breckenedge/parametric-brick-boxes/README.md

# Parametric brick boxes

Printable, parametric storage boxes, LEGO-compatible and written in OpenSCAD:
studded edge to edge on every side and on the lid (each face can be studs, sockets
or flat), with storage inside.

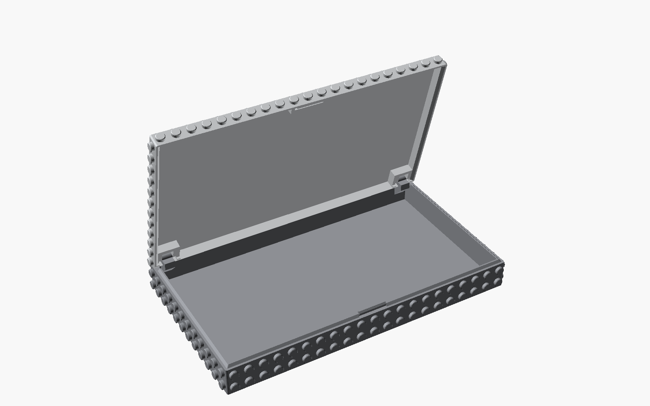
[picture p1: images/open.png]
A 21 x 12 stud box with its hinged lid open


| Closed | Studs only front and back |
|---|---|
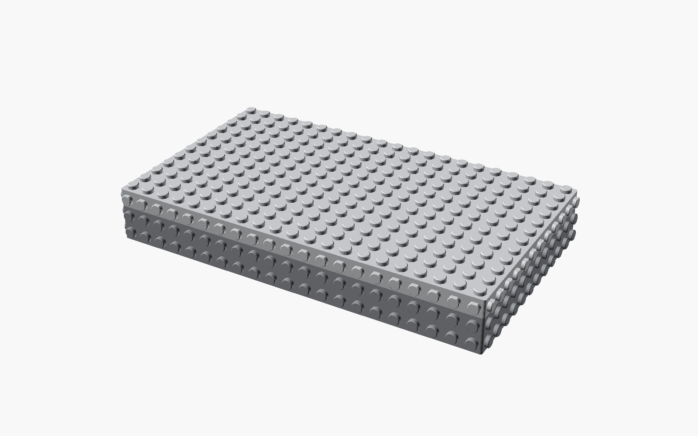
[picture p2: images/closed.png]
Closed box, studded on every face
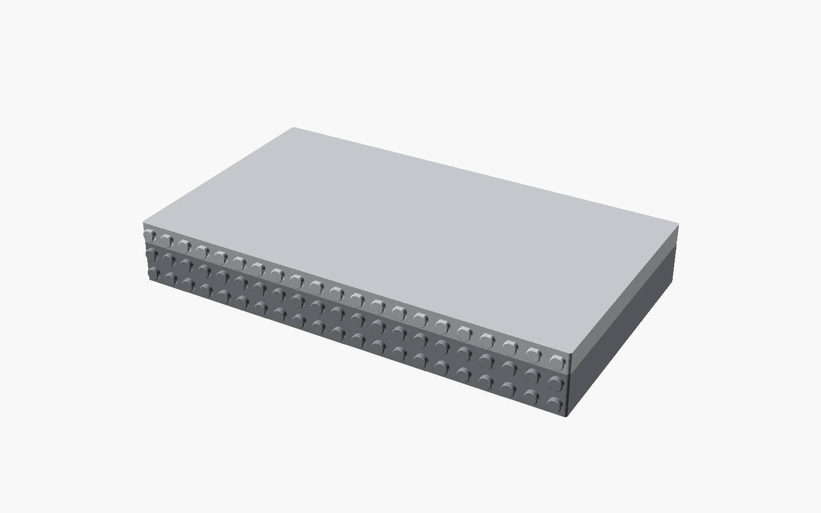
[picture p3: images/faces.png]
Box with a plain lid top and plain ends, studs only on the front and back
|  |  |
| **Print layout** | **Rows 0, 1 and 2** |
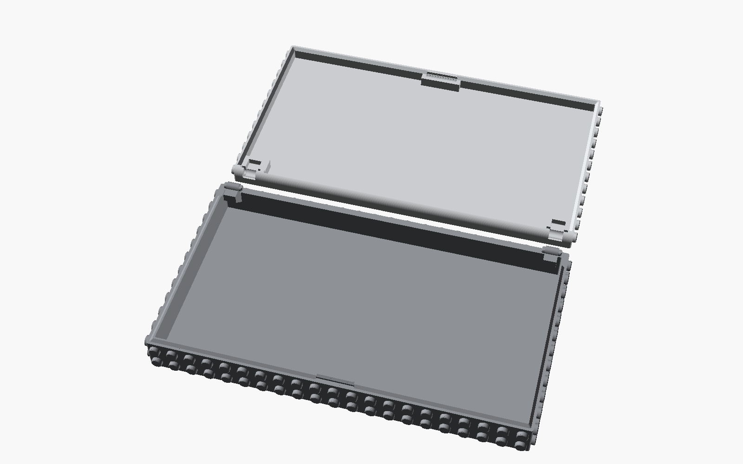
[picture p4: images/print.png]
Body upright, lid beside it
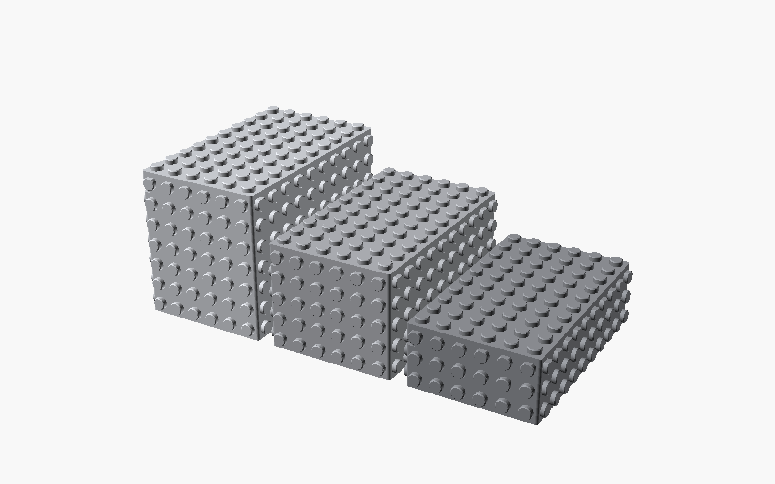
[picture p5: images/lineup.png]
Three boxes stepping up from front to back
|  |  |

- Everything is in LEGO units: footprints in studs (8 mm), heights in stud rows (8 mm).
- Box size is set directly in studs (`studs_l` x `studs_w`).
- Every box is whole stud rows tall, with studs round the lid band too, so the side
  studs of neighbouring boxes line up. `side_rows` sets the height and `lid_rows` how
  many of those rows are lid. A lid taller than one row swings out behind the box by
  8 mm per extra row when it's open.
- Every face (`top`, `bottom`, `front`, `back`, `left`, `right`) is set to `studs`,
  `sockets` or `flat` in the Customizer's **Studs** group. Sockets are built like a
  LEGO brick's underside: a shallow recess with hollow tubes between each group of four
  studs (small pins along a face only one stud wide), so a box presses onto a baseplate
  or onto another box's studs without a thick solid plate under it. Flat faces take
  a label, or stand flush against a wall or another box.
- Optional text label on the lid top (**Lid label** group): set `label`, and it's
  centred on the lid with the top studs or sockets round it left out. The text is
  engraved into the top skin (prints without supports) or raised off it (`label_style`),
  in any installed font (`label_font`), can lean into italics (`label_slant`) and can be
  turned to any angle (`label_rotate`).
- Set `row` for where the box will stand (0 = front): each row back is taller, so
  whatever stands on the boxes in back sits higher.
- Hinged lid on two pinned tabs at the back. On a two-piece box, friction holds it at any angle up to 90°,
  and it lifts off at 90°.
- Hollow lid: a thin top skin (`lid_top`, thickened automatically under top sockets) over
  an open underside, inside the outer lip, with solid blocks only round the hinge slots
  and the detent.
- Snaps shut on a detent: a bead on the front wall top clicks into the lid; squeeze the
  middle of the box front to release it (`detent_count`, `detent_len`; `detent_bump` sets
  how firm the snap is).
- By default (`part = print_in_place`) it prints as one piece, the body upright with the
  lid standing open on it: no assembly, and the hinge can't come apart (`pip_gap` sets
  the clearance between the parts). This only suits small lids: the open lid stands
  as tall as the box is wide (`studs_w`), and a tall one gets knocked over or takes
  the box with it. On the author's A1, a 6 x 5 box comes out well. An 8-stud-wide box
  failed at about the lid's third row of studs: the whole box came loose, even on the
  textured PEI plate. With the lid turned parallel to the Y axis (on a bed slinger the
  standing lid should be perpendicular to it), the lid wobbled badly at about 6 studs.
  OpenSCAD warns in the console when an open lid would stand over 5 studs tall.
  For a bigger box, pick `part = print` for two pieces, the body
  and the lid both upright, on a snug friction hinge you assemble: hold the lid straight
  up (open 90°) and press it onto the tabs. They only go in at that angle, and it lifts
  off the same way. The lid prints top up,
  its flat bottom edge on the bed, bridging over its hollow underside: on the author's A1,
  a 4 x 4 lid printed fine without supports. Or set `lid_inverted` to print it top down,
  with no bridge over the hollow (top studs then stand on the bed). The body needs supports only on bottom studs; with bottom
  `sockets` or `flat` it prints flat without supports. Print
  `stud_fit_test.scad` first to find your stud and socket sizes, then a small 6 x 5 box
  to check the whole fit.
  For reference, on the author's Bambu Lab A1 printing
  [SUNLU PLA 2.0+](https://www.breckenridge.dev/amazon.html?asin=B0FG7VTXTY) (affiliate link), these clutch
  well: `stud_d` (top studs) 5.05, `side_stud_d` (side studs) 4.95–5.00,
  `socket_d` (top and bottom sockets) 4.95 and `side_socket_d` (side sockets)
  4.85–4.95.

## Use

Open `parametric_brick_boxes.scad` in OpenSCAD (a recent nightly with the
Manifold backend renders much faster) and use the Customizer. Set the size and `row`,
pick `part = print_in_place / print / body / lid`, then render and export.

`tools/build_3mf.sh` builds ready-to-print Bambu Studio projects for the A1 (Windows, Git
Bash; it runs OpenSCAD and Bambu Studio), e.g. `tools/build_3mf.sh 3mf 6x5 16x8`. Boxes
up to 5 studs wide come out printed in place, wider ones in two pieces. Only the lid of a
two-piece box gets supports, tree supports from the bed under its long bridged top
(`LID_SUPPORTS=0` turns them off; `SUPPORTS=1` puts them everywhere, for bottom studs;
`LID_INVERTED=1` prints the lids top down instead, without them).
Every box gets a 5 mm outer brim, since
a body with bottom sockets only meets the bed with a thin rim (`BRIM=0` turns it off).
The printer, filament, process and stud sizes are variables at the top of the script.

`archive/` holds an earlier, decorative pillar version.

## License

© 2026 Aaron Breckenridge. Licensed under
[Creative Commons Attribution-ShareAlike 4.0 International](https://creativecommons.org/licenses/by-sa/4.0/)
(CC BY-SA 4.0); see [LICENSE](LICENSE).

The label's default font, [Fredoka](https://fonts.google.com/specimen/Fredoka)
(`fonts/Fredoka.ttf`), is © The Fredoka Project Authors, under the
[SIL Open Font License 1.1](fonts/OFL.txt).

LEGO® is a trademark of the LEGO Group, which does not sponsor, authorize or endorse
this project.

As an Amazon Associate I earn from qualifying purchases made through the product links
above.
