breckenedge/parametric-brick-boxes/(list of files, cad)

Other CAD files:
speed_champions_brick_boxes.scad
archive/speed_champions_pillars.scad
