breckenedge/parametric-brick-boxes/(commit log)

2026-10-12 Parametric brick display boxes for Speed Champions cars
    OpenSCAD boxes in LEGO units with studded lid and side panels, sized
    per car class and packed onto the shelf with back rows higher.
    [speed_champions_brick_boxes.scad, speed_champions_pillars.scad]
2026-10-13 Hinged lid, stud fit test, plinth bands, Customizer cleanup
    - Hinged lid (default): friction-fit pins on two buttressed tabs at the
    back, flatted so the lid only slides on or off at 90 degrees.
    lid_style = "seat" keeps the plain lift-off lid.
    - Customizer: descriptions moved above parameters so dropdowns and
    sliders work; fig_side / fig_align are now dropdowns; car_h removed;
    car_l minimum is 6.
    - Studs: chamfered 1.8 mm profile; new stud_fit_test.scad prints a
    strip of upright and sideways studs at six diameters.
    - Recessed plinth band at the bottom of the body, mirrored at the top
    of the lid, to hide the first-layer / cooling line.
    - Gray preview colours.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
    [speed_champions_brick_boxes.scad, stud_fit_test.scad]
2026-10-13 Snap latch on the front of the lid
    A springy tongue stands up inside the front wall on a block glued to
    the wall. Its 45 degree bump rides over a catch lip on the lid and
    clicks into a notch, so the lid snaps shut and pulls open again.
    latch_count picks 0, 1 (centred) or 2 latches; latch_bump sets how far
    the tongue bends, which sets how firm the snap is.
    [speed_champions_brick_boxes.scad]
2026-10-13 Replace latch tongue with a detent on the front lip
    The tongue looked fragile. Instead a 45 degree bead runs along the
    inside of the front wall ridge and clicks into a matching groove in the
    lid's plug; the wall top springs out to let the lid by. It fits within
    the existing ridge, so the lip did not need to grow. detent_count,
    detent_len and detent_bump replace the latch settings.
    [speed_champions_brick_boxes.scad]
2026-10-13 Merge fig_side and fig_align into one compass setting
    fig_dir picks where the minifigs stand: N/S along the back/front,
    centred; E/W across the right/left end; corners at that end of the
    back or front. The default, SE, matches the old front + right.
    [speed_champions_brick_boxes.scad]
2026-10-13 Set box size directly in studs
    studs_l x studs_w is now the whole footprint, and nothing else changes
    it: fig_dir, fig_count and fig_strip only move the figures and the car
    around the top. The car_size presets, car_w and car_l are gone; the
    header lists box sizes that suit each car class instead. box_sizes now
    takes [studs_l, studs_w] per box. Warns when the figure strip leaves
    no room for a car.
    [speed_champions_brick_boxes.scad]
2026-10-13 Default stud sizes from the fit test: 5.0 top, 4.9 side
    [speed_champions_brick_boxes.scad]
2026-10-13 Keep stud defaults; note tested sizes in the README
    Reverts 72c6049. The fit test's results (5.00 top, 4.90 side, PLA+)
    go in the README as a reference instead of changing the defaults.
    [speed_champions_brick_boxes.scad]
2026-10-14 frame = 0: edge-to-edge side studs, lid band row, no recesses
    Studs cover every face from corner to corner and bottom to top, with one
    row round the lid band (not its back when hinged, which lands on the wall
    top at 90 deg). No panel recesses or plinths, corners rounded 1 mm at
    most, and the box is whole stud rows tall.
    [speed_champions_brick_boxes.scad]
2026-10-14 README: frame = 0
2026-10-14 Detent releases on a squeeze
    The bead now faces out from a catch post on the front wall top and clicks
    into the lid's front skin, so squeezing the front of the box bows the wall
    in and frees the lid (it used to drive the bead deeper). The lid's plug is
    cut back behind the post to give the wall room.
    [speed_champions_brick_boxes.scad]
2026-10-14 Detent post no taller than the ridge
    Flat top level with the wall ridge behind a 45 deg chamfer, instead of a
    slope climbing 1.8 mm higher; the lid's pocket over it gets a 45 deg gable.
    [speed_champions_brick_boxes.scad]
2026-10-14 Drop the shelf layout and ghosts: one box, set by row
    The shelf size, auto-packed layout, box_n, box_sizes, box_figs and gap
    are gone; a row setting (0 = front) adds rise stud rows per row back, so
    the back-higher rule still holds. show_cars and the ghost car / minifigs
    are gone too. The console now describes the one box.
    [speed_champions_brick_boxes.scad]
2026-10-14 Frameless only: remove frame, recessed panels and plinths
    Studs always run edge to edge with a row round the lid band, so frame,
    panel_depth, panel_max, panel_play, skin, the plinth settings and the
    bottom border band are gone. Wall thickness is now its own setting (wall,
    4.8 mm as before). panels_* become studs_*, corner_r tops out at 1.5 mm,
    and the default box shrinks to 21 x 12 (the same top as 23 x 14 with a
    frame). The size table is updated to match.
    [speed_champions_brick_boxes.scad]
2026-10-14 Thinner walls: 3.2 mm by default
    The hinge tab's buttress top now sits flush with the seam behind the axis,
    so walls under 4.4 mm no longer touch the lid at 90 deg; checked at 2.4 and
    3.2 mm. Below 3.2 mm the console notes how thin the seat ridge and the
    lid skin over the detent get.
    [speed_champions_brick_boxes.scad]
2026-10-14 Drop the lift-off seat lid; hinge only
    Removes lid_style and lid_lift; the hinge settings stay. Output is
    unchanged for the hinged box.
    [speed_champions_brick_boxes.scad]
2026-10-14 Hollow lid: open under a thin top skin, solid round hinges and detent
    [speed_champions_brick_boxes.scad]
2026-10-14 Lid: drop the inner plug ring, keep only the sloped outer lip
    [speed_champions_brick_boxes.scad]
2026-10-14 Print the lid inverted; flip the lid band's side stud flats to match
    [speed_champions_brick_boxes.scad]
2026-10-14 Drop minifig options, fig pads and side stud patterns (grid only)
    [speed_champions_brick_boxes.scad]
2026-10-14 Drop side_cols: side studs always run edge to edge
    [speed_champions_brick_boxes.scad]
2026-10-14 Drop the car size table from the header
    [speed_champions_brick_boxes.scad]
2026-10-14 Rename to Parametric brick boxes: parametric_brick_boxes.scad
    [parametric_brick_boxes.scad, stud_fit_test.scad]
2026-10-14 Count the lid band in side_rows: box is side_rows tall in all
    The default (2) now makes a box one row shorter than before; old side_rows N
    is new N + 1. Minimum is 2: one body row under the lid band.
    [parametric_brick_boxes.scad]
2026-10-14 Add renders to the README: open, closed, print layout, row lineup
2026-10-14 README: name the reference printer and filament
2026-10-15 Add lid_rows: the lid band can be any number of stud rows tall
    side_rows still sets the whole height; lid_rows says how many of those rows
    are lid. The hinge axis now sits half a row above the seam instead of half a
    row below the top, so the hinge is the same for any lid height. lid_rows = 1
    renders byte-identical to before; 2 and 3 open 0-90 deg without collisions.
    [parametric_brick_boxes.scad]
2026-10-15 Stud the back of the lid above its hinge row
    Only the lid's bottom row lands on the wall top at 90 deg, so the rows above
    it (lid_rows - 1) get back studs too. lid_rows = 1 is unchanged; 2 and 3 still
    open 0-90 deg without collisions.
    [parametric_brick_boxes.scad]
2026-10-15 Add bottom_studs: studs over the underside, pointing down
    On by default. The body then prints upright standing on them, on supports,
    like the lid on its top studs; with it off the output is byte-identical to
    before.
    [parametric_brick_boxes.scad]
2026-10-15 Each face can be studs, sockets or flat
    top, bottom, front, back, left and right replace the stud on/off toggles.
    Sockets are chamfered holes stud_h + 0.2 deep with 1.2 mm behind them:
    round in the top and bottom (socket_d), teardrops pointed up as printed in
    the walls (side_socket_d), tips flattened so lid-band sockets clear the
    groove. The floor and lid top thicken to 3.2 under sockets; lid sockets skip
    the detent pocket and the hinge slots. Neither part needs supports with
    sockets or flat in place of studs on its bed face. stud_fit_test.scad gains
    socket groups for tuning. All-studs output is byte-identical to before.
    [parametric_brick_boxes.scad, stud_fit_test.scad]
2026-10-15 Allow 4-stud boxes; warn when the detents don't fit along the front
    studs_l and studs_w now go down to 4. A 4 x 4 box opens 0-90 deg without
    collisions with the default detent. Detents that run into the end walls or
    into each other (two 2-stud detents on a 4-stud box, or one as long as the
    box, which already broke at 5) now get a warning, like the hinge tabs do.
    [parametric_brick_boxes.scad]
2026-10-15 Add an optional text label on the lid top, engraved or raised
    The label sits in a window of whole stud columns and rows centred on
    the lid, with the top studs or sockets left out inside it.
    [parametric_brick_boxes.scad]
2026-10-15 Size the label's stud-free window from the text itself
    label_l and label_w are gone: the label is centred on the lid, and any
    top stud or socket within 1 mm of the text's outline is left out. Warns
    when the text runs off the lid top.
    [parametric_brick_boxes.scad]
2026-10-15 Let label_depth go to 0: just the stud-free space, no text
    [parametric_brick_boxes.scad]
2026-10-15 Add label_slant: lean the label into italics, for any font
    [parametric_brick_boxes.scad]
2026-10-15 Label defaults: "bricks" in Fredoka Bold, slanted 10 deg, engraved
    Fredoka (SIL OFL 1.1) ships in fonts/ and loads with use <>, so the
    label renders the same without installing it. label_font is tagged
    // font for MakerWorld's font picker.
    [parametric_brick_boxes.scad]
2026-10-15 Default box: 22 x 8 studs, 3 rows tall
    [parametric_brick_boxes.scad]
2026-10-15 corner_r rounds the lid's top perimeter too
    [parametric_brick_boxes.scad]
2026-10-15 Default box: flat bottom and back
    The body prints without supports, and the box stands flush against a
    cabinet's back wall.
    [parametric_brick_boxes.scad]
2026-10-15 Sockets built like a LEGO brick's underside
    Each socket face is one shallow recess with hollow tubes between every
    four studs (solid pins along a single row), in place of a hole per stud
    in a solid plate. Where two socket faces meet, each recess stays back
    from the shared edge and takes the edge studs in round holes, so the
    corner stays solid. The label and the hinge slots keep whole stud cells
    solid. stud_fit_test.scad prints the same 2 x 2 recess and tube.
    [parametric_brick_boxes.scad, stud_fit_test.scad]
2026-10-15 Fit test: label every group, underside and both wall faces too
    The wall is 4 mm taller to make room above its groups.
    [stud_fit_test.scad]
2026-10-15 Fit test: a 1 x 2 wall socket group with a pin per diameter
    Tests the single-row sockets a 1-row lid band gets. The wall grows a
    row to fit them.
    [stud_fit_test.scad]
2026-10-15 Fit test: a 1 x 2 underside socket group per diameter too
    [stud_fit_test.scad]
2026-10-15 Reflow the fit test's underside note
    [stud_fit_test.scad]
2026-10-15 README: A1 fit-test results for studs and sockets
2026-10-15 Print-in-place mode: body and lid as one piece, the lid standing open
    print_in_place prints the lid hinged open 90 deg on the body. pip_gap
    separates them: round the tabs, round the pins (no lead-in, so they stay
    captive), and under the lid, where the wall tops and buttress tops it
    stands on drop by pip_gap. The lid's hollow gets a 45 deg ceiling, its
    top studs print sideways with a flat (side_stud_d) and its front band's
    studs upright (stud_d). Output is unchanged with it off.
    [parametric_brick_boxes.scad]
2026-10-15 Print in place is a part choice, not a separate switch
    [parametric_brick_boxes.scad]
2026-10-15 README: affiliate link for the filament, updated fit values
    Links SUNLU PLA 2.0+ through the referral redirect on breckenridge.dev
    and adds the Amazon Associates disclosure. Also carries the updated
    stud_d (5.05) and socket_d (4.95) reference values.
2026-10-15 Ready-to-print Bambu Studio 3MFs in four sizes
    6 x 5, 8 x 8, 16 x 8 and 22 x 8 studs, each two-piece (supports on for
    the lid's studs) and print-in-place, for the A1 with SUNLU PLA+ 2.0 at
    0.20mm Standard on the textured PEI plate. Built with stud_d 5.05,
    side_stud_d 5.00, socket_d 4.95 and side_socket_d 4.90.
2026-10-15 Add the 3MF projects the README lists
    They were left out by the *.3mf ignore rule; 3mf/ is now excepted.
    [brick_box_16x8.3mf, brick_box_16x8_print_in_place.3mf, brick_box_22x8.3mf, brick_box_22x8_print_in_place.3mf, brick_box_6x5.3mf, brick_box_6x5_print_in_place.3mf, brick_box_8x8.3mf, brick_box_8x8_print_in_place.3mf]
2026-10-15 Print in place: a firmer clasp that prints without bridging
    The loose pins let the shut lid slide pip_gap forward, which took up
    the whole detent bump: the bead now stands out pip_gap further (and
    the lid pocket gives the wall that much more room to bow in). Standing
    open, the lid's front skin is a ceiling over the post, so the groove's
    flat tip and the strip below it were bridged and strung: the bead now
    comes to a point at the foot of the post, making the groove all 45 deg
    faces that run on into the chamfer. Two-piece output is unchanged;
    the print-in-place 3MFs are rebuilt.
    [brick_box_16x8_print_in_place.3mf, brick_box_22x8_print_in_place.3mf, brick_box_6x5_print_in_place.3mf, brick_box_8x8_print_in_place.3mf, parametric_brick_boxes.scad]
2026-10-15 Print in place: slope the detent block's underside
    Standing open, the solid block round the lid's detent pocket had a flat
    underside about 20 x 10 mm hanging over the hollow, with nothing under
    it. It now slopes 45 deg in to the top skin. A scan for overhangs past
    45 deg inside the footprint finds only the lid's landing strip on the
    back wall and the hinge slots, both already proven in print. Two-piece
    output is unchanged; the print-in-place 3MFs are rebuilt.
    [brick_box_16x8_print_in_place.3mf, brick_box_22x8_print_in_place.3mf, brick_box_6x5_print_in_place.3mf, brick_box_8x8_print_in_place.3mf, parametric_brick_boxes.scad]
2026-10-15 Default to flat sides and sockets on the bottom and back
    left and right now default to flat, bottom and back to sockets; top
    and front stay studs.
    [parametric_brick_boxes.scad]
2026-10-15 Print in place: anchor the edge of the lid's detent pocket
    Standing open, the skin below the groove (the face that catches the
    bead) hung below the groove's apex with nothing to start from: the
    lid's seat groove beside the pocket stopped short of it. The bead now
    sits DT_LIP (0.8) higher, leaving a flat strip on the skin's edge as
    its first layer, and for BEEF either side of the pocket the wall's seat
    ridge is cut away and the lid comes down solid, so the strip bridges
    between anchored ends. Closed and open clearances check out, with one
    detent or two; two-piece output is unchanged.
    [parametric_brick_boxes.scad]
2026-10-15 Rebuild the 3MFs: new default faces and the anchored clasp
    All eight now have studs on the top and front, sockets on the bottom
    and back and flat sides, and the print-in-place ones carry the
    anchored detent.
    [brick_box_16x8.3mf, brick_box_16x8_print_in_place.3mf, brick_box_22x8.3mf, brick_box_22x8_print_in_place.3mf, brick_box_6x5.3mf, brick_box_6x5_print_in_place.3mf, brick_box_8x8.3mf, brick_box_8x8_print_in_place.3mf]
2026-10-15 Default to print in place; drop the two-piece 3MFs
    [brick_box_16x8.3mf, brick_box_22x8.3mf, brick_box_6x5.3mf, brick_box_8x8.3mf, parametric_brick_boxes.scad]
2026-10-16 README: orient a print-in-place lid perpendicular to Y on a bed slinger
2026-10-16 README: report the tall print-in-place lid wobbling on the A1
2026-10-16 README: print in place only suits small lids
2026-10-16 Print in place: warn when the open lid stands over 5 studs tall
    [parametric_brick_boxes.scad]
2026-10-16 Remove the generated 3MF projects
    [brick_box_16x8_print_in_place.3mf, brick_box_22x8_print_in_place.3mf, brick_box_6x5_print_in_place.3mf, brick_box_8x8_print_in_place.3mf]
2026-10-16 Sockets: a stud fits inside the tubes too (hole = socket diameter)
    [parametric_brick_boxes.scad, stud_fit_test.scad]
2026-10-16 Label: turn it to any angle on the lid top (label_rotate)
    [parametric_brick_boxes.scad]
2026-10-16 Drop part = assembled (and lid_open): only printable layouts left
    [parametric_brick_boxes.scad]
2026-10-17 Two-piece: print the lid top up, on supports under its hollow
    [parametric_brick_boxes.scad]
2026-10-17 Two-piece lid: ribs from the bed hold up the top skin
    [parametric_brick_boxes.scad]
2026-10-17 Drop the lid ribs
    This reverts commit 7bebe4a.
    [parametric_brick_boxes.scad]
2026-10-17 Two-piece lid: hinge and detent blocks come down to the bed
    [parametric_brick_boxes.scad]
2026-10-17 Two-piece: flat wall top, the lid sits flush and prints flat on the bed
    [parametric_brick_boxes.scad]
2026-10-17 Two-piece lid: chamfer the lower back edge instead of rounding it
    [parametric_brick_boxes.scad]
2026-10-17 README: a 4 x 4 lid printed top up without supports
2026-10-17 build_3mf.sh: 5 mm outer brim by default (BRIM=0 for none)
2026-10-17 build_3mf.sh: tree supports on two-piece lids over 5 studs wide only
    Their top skin bridges ~57 mm at 8 wide; the 4-wide lid's 26 mm bridged fine.
    The body never gets supports (they would fill the bottom socket recesses).
2026-10-19 Add bridge_test.scad: 20-60 mm bridge spans to find the filament's limit
    [bridge_test.scad]
2026-10-19 Wall sockets: a 45 deg roof over each top-row stud, not one flat ceiling
    The recess ceiling ran the whole face (205 mm on a 26-stud back) as one flat
    overhang and printed stringy. Each top stud now gets its own roof, keeping a
    short flat at its top so it still grips; between studs only ~3 mm ledges remain.
    [bridge_test.scad, parametric_brick_boxes.scad]
2026-10-19 Wall sockets: ribs under the flat ceiling instead of a roof per stud
    A 1.2 mm rib between each pair of top studs, from the ceiling into the tube
    wall (or pin) below, breaks the ceiling into 6.8 mm bridges anchored at both
    ends, and keeps the full flat over each stud. Replaces the 45 deg roofs, which
    left unanchored 3 mm ledges between studs.
    [parametric_brick_boxes.scad]
2026-10-19 Wall sockets: ribs the whole height, floor to ceiling through the tubes
    [parametric_brick_boxes.scad]
2026-10-19 Bottom sockets: ribs front to back tie the tubes to each other and the walls
    Keeps the print head from knocking the thin tubes loose, and adds a little
    first-layer area.
    [parametric_brick_boxes.scad]
2026-10-19 Socket tubes and pins: straight cylinders, no chamfered tip
    Same in stud_fit_test.scad, so the test matches the boxes.
    [parametric_brick_boxes.scad, stud_fit_test.scad]
2026-10-19 Hinge tabs: buttress 0.5 mm into the back wall so the tabs fuse with it
    The axis is HR = 4 mm in from the back face but the wall is 3.2 mm, so the
    buttress ended flush on the wall's inner face: touching, not overlapping, and
    each tab came out as its own shell (Bambu Studio showed separate parts).
    [parametric_brick_boxes.scad]
2026-10-19 Add lid_inverted: print the two-piece lid top down (LID_INVERTED=1 in build_3mf.sh)
    [parametric_brick_boxes.scad]
